malayan-tapir/WoBo40/hardware/wobo40/wobo40.kicad_sch

## KiCad design hardware/wobo40/wobo40.kicad_sch (2026-09-09)

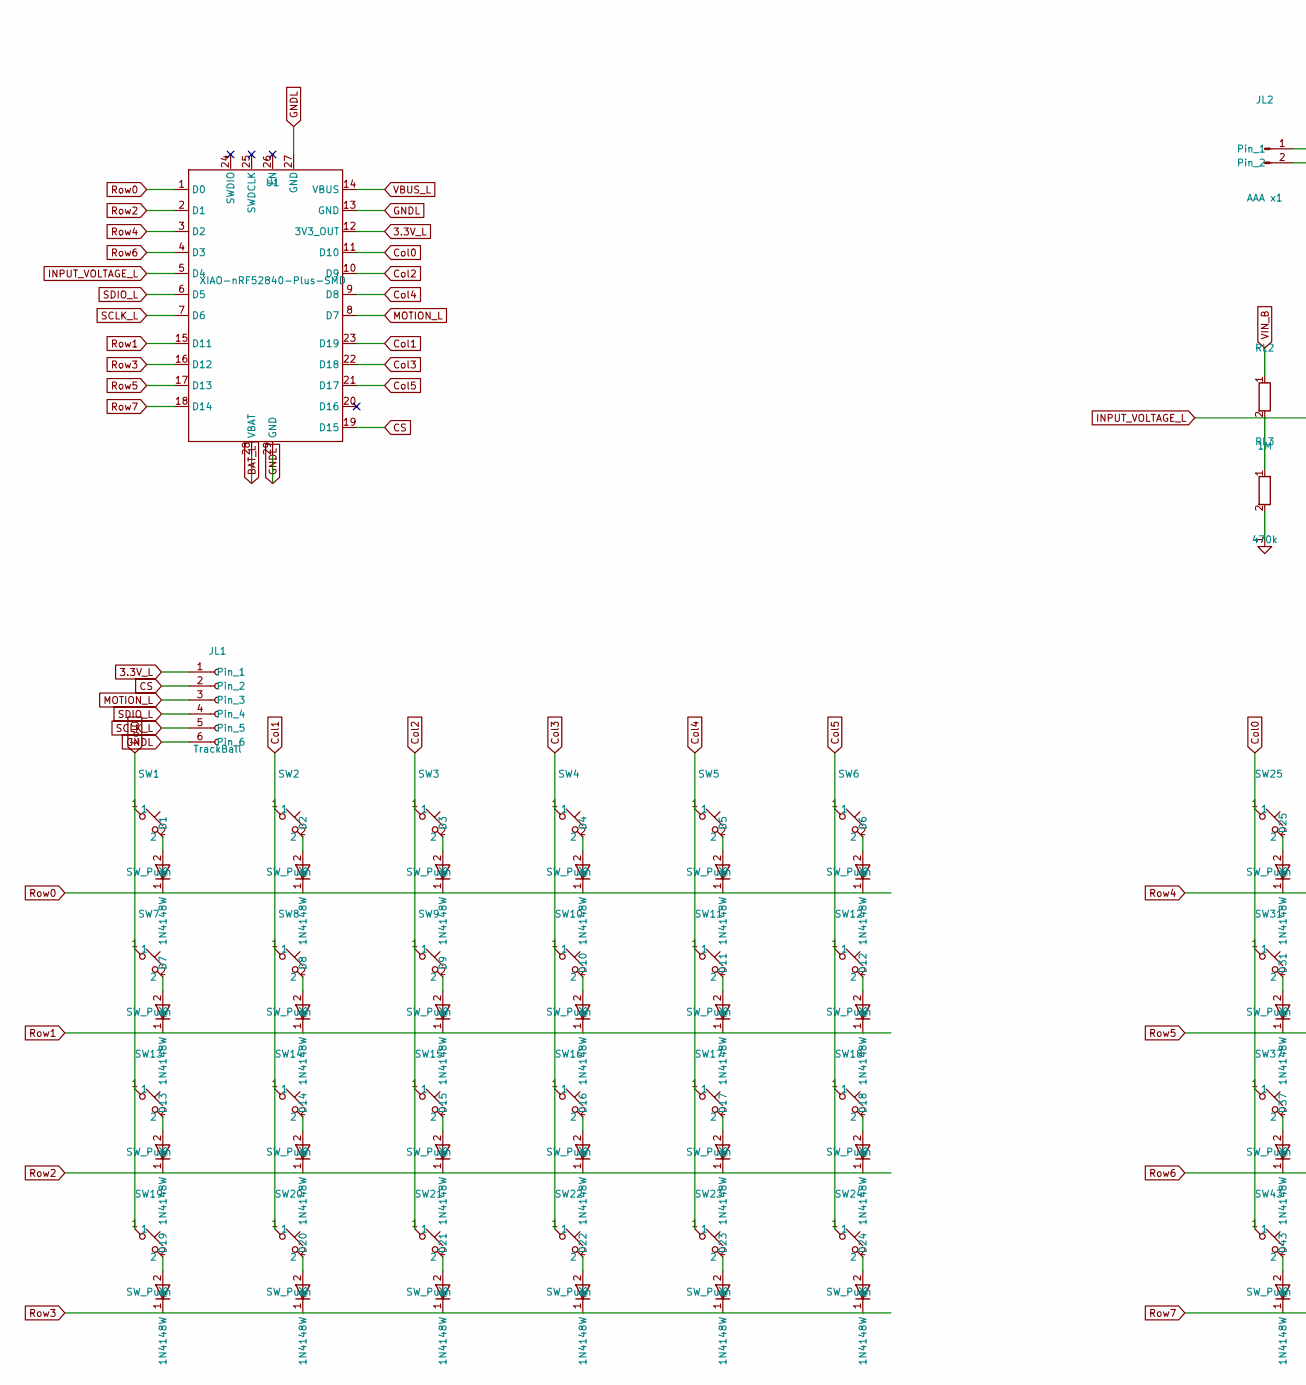
[picture p1: schematic wobo40.kicad_sch, part in row 1, column 1]

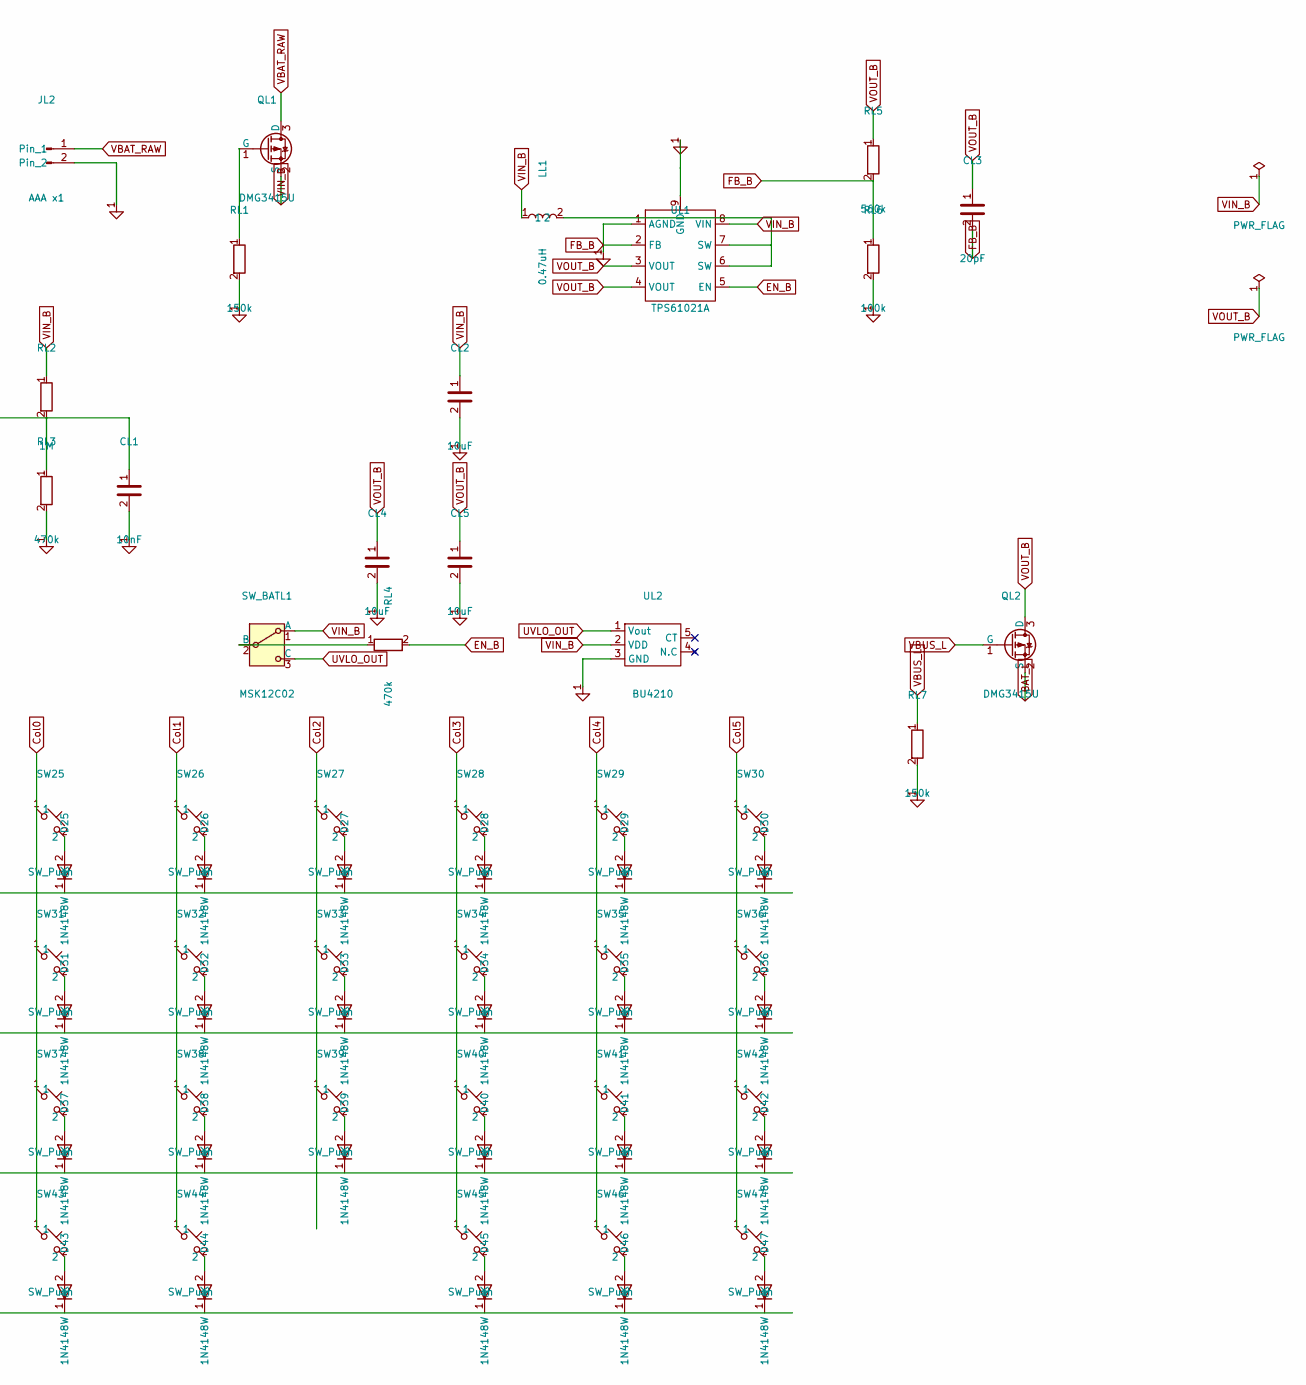
[picture p2: schematic wobo40.kicad_sch, part in row 1, column 2]

Parts:
CL1: 10nF; C_0603_1608Metric
CL2, CL4, CL5: 10uF; C_0603_1608Metric
CL3: 20pF; C_0603_1608Metric
D1, D2, D3, D4, D5, D6, D7, D8, D9, D10, D11, D12, D13, D14, D15, D16, D17, D18, D19, D20, D21, D22, D23, D24, D25, D26, D27, D28, D29, D30, D31, D32, D33, D34, D35, D36, D37, D38, D39, D40, D41, D42, D43, D44, D45, D46, D47: 1N4148W; D_SOD-123
JL1: TrackBall; JST_SH_SM06B-SRSS-TB_1x06-1MP_P1.00mm_Horizontal
JL2: AAA x1
LL1: 0.47uH; L_1008_2520Metric
QL1, QL2: DMG3415U; SOT-23
RL1, RL7: 150k; R_0603_1608Metric
RL2: 1M; R_0603_1608Metric
RL3, RL4: 470k; R_0603_1608Metric
RL5: 560k; R_0603_1608Metric
RL6: 100k; R_0603_1608Metric
SW1, SW2, SW3, SW4, SW5, SW6, SW7, SW8, SW9, SW10, SW11, SW12, SW13, SW14, SW15, SW16, SW17, SW18, SW19, SW20, SW21, SW22, SW23, SW24, SW25, SW26, SW27, SW28, SW29, SW30, SW31, SW32, SW33, SW34, SW35, SW36, SW37, SW38, SW39, SW40, SW41, SW42, SW43, SW44, SW45, SW46, SW47: SW_Push
SW_BATL1: MSK12C02
U1: XIAO-nRF52840-Plus-SMD
UL1: TPS61021A; WSON-8-1EP_2x2mm_P0.5mm_EP0.9x1.6mm
UL2: BU4210; SSOP-5_1.6x1.6mm_P0.5mm

Connections:
3.3V_L: JL1.1, U1.12 (3V3_OUT)
BAT_L: QL2.2 (S), U1.28 (VBAT)
CS: JL1.2, U1.19 (D15)
Col0: SW19.1, SW43.1, U1.11 (D10)
Col1: SW20.1, SW44.1, U1.23 (D19)
Col2: SW21.1, U1.10 (D9)
Col3: SW22.1, SW45.1, U1.22 (D18)
Col4: SW23.1, SW46.1, U1.9 (D8)
Col5: SW24.1, SW47.1, U1.21 (D17)
EN_B: RL4.2, UL1.5 (EN)
FB_B: CL1.2, CL2.2, CL3.2, CL4.2, CL5.2, JL2.2, RL1.2, RL3.2, RL5.2, RL6.1, RL6.2, RL7.2, UL1.1 (AGND), UL1.2 (FB), UL1.9 (GND), UL2.3 (GND)
GNDL: JL1.6, U1.13 (GND), U1.27 (GND), U1.29 (GND)
INPUT_VOLTAGE_L: CL1.1, RL2.2, RL3.1, U1.5 (D4)
MOTION_L: JL1.3, U1.8 (D7)
unnamed: D1.2 (A), SW1.2
unnamed: D2.2 (A), SW2.2
unnamed: D3.2 (A), SW3.2
unnamed: D4.2 (A), SW4.2
unnamed: D5.2 (A), SW5.2
unnamed: D6.2 (A), SW6.2
unnamed: D7.2 (A), SW7.2
unnamed: D8.2 (A), SW8.2
unnamed: D9.2 (A), SW9.2
unnamed: D10.2 (A), SW10.2
unnamed: D11.2 (A), SW11.2
unnamed: D12.2 (A), SW12.2
unnamed: D13.2 (A), SW13.2
unnamed: D14.2 (A), SW14.2
unnamed: D15.2 (A), SW15.2
unnamed: D16.2 (A), SW16.2
unnamed: D17.2 (A), SW17.2
unnamed: D18.2 (A), SW18.2
unnamed: D19.2 (A), SW19.2
unnamed: D20.2 (A), SW20.2
unnamed: D21.2 (A), SW21.2
unnamed: D22.2 (A), SW22.2
unnamed: D23.2 (A), SW23.2
unnamed: D24.2 (A), SW24.2
unnamed: D25.2 (A), SW25.2
unnamed: D26.2 (A), SW26.2
unnamed: D27.2 (A), SW27.2
unnamed: D28.2 (A), SW28.2
unnamed: D29.2 (A), SW29.2
unnamed: D30.2 (A), SW30.2
unnamed: D31.2 (A), SW31.2
unnamed: D32.2 (A), SW32.2
unnamed: D33.2 (A), SW33.2
unnamed: D34.2 (A), SW34.2
unnamed: D35.2 (A), SW35.2
unnamed: D36.2 (A), SW36.2
unnamed: D37.2 (A), SW37.2
unnamed: D38.2 (A), SW38.2
unnamed: D39.2 (A), SW39.2
unnamed: D40.2 (A), SW40.2
unnamed: D41.2 (A), SW41.2
unnamed: D42.2 (A), SW42.2
unnamed: D43.2 (A), SW43.2
unnamed: D44.2 (A), SW44.2
unnamed: D45.2 (A), SW45.2
unnamed: D46.2 (A), SW46.2
unnamed: D47.2 (A), SW47.2
unnamed: LL1.2, UL1.6 (SW), UL1.7 (SW)
unnamed: QL1.1 (G), RL1.1
unnamed: RL4.1, SW_BATL1.2 (B)
Row0: U1.1 (D0)
Row1: U1.15 (D11)
Row2: U1.2 (D1)
Row3: U1.16 (D12)
Row4: U1.3 (D2)
Row5: U1.17 (D13)
Row6: U1.4 (D3)
Row7: U1.18 (D14)
SCLK_L: JL1.5, U1.7 (D6)
SDIO_L: JL1.4, U1.6 (D5)
UVLO_OUT: SW_BATL1.3 (C), UL2.1 (Vout)
VBAT_RAW: JL2.1, QL1.3 (D)
VBUS_L: QL2.1 (G), RL7.1, U1.14 (VBUS)
VIN_B: CL2.1, LL1.1, QL1.2 (S), RL2.1, SW_BATL1.1 (A), UL1.8 (VIN), UL2.2 (VDD)
VOUT_B: CL3.1, CL4.1, CL5.1, QL2.3 (D), RL5.1, UL1.3 (VOUT), UL1.4 (VOUT)
