malayan-tapir/WoBo40/(commit log)

2026-07-12 WoBo40: XIAO BLE + ZMK + 1Uトラックボール構成一式を追加
    - 4行x13列 (51キー) オーソリニア、トラックボール位置(Row3/C8)は除外
    - 列駆動: 74HC595 x2 をSPI1で駆動 (ZMK標準 zmk,gpio-595, ngpios=16)
    - トラックボール: PMW3610 (inorichi/zmk-pmw3610-driver, SPI0 3線接続)
    - ボール移動でMouseレイヤー自動有効化、fn押下中はスクロール
    - キーマップ: Base / Mouse / Fn / Sys の4レイヤー (Mac/JIS想定, 英数/かな対応)
    - ZMK Studio対応 (physical layout定義 + studioビルド)
    - GitHub Actionsビルドマトリクス: studio版 / 通常版 / settings_reset
    - 配線・ピンアサイン・使い方をREADMEに記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
2026-07-13 キースキャンをCharlieplex方式に変更 (74HC595を廃止)
    - スキャン8ピン (D0-D3, D8-D10, NFC1/P0.09) + 割り込み1ピン (NFC2/P0.10)
    の zmk,kscan-gpio-charlieplex 構成に変更 (8x7=56ポジション中51使用)
    - NFCピンGPIO化のため CONFIG_NFCT_PINS_AS_GPIOS=y を追加
    - transform を駆動ピン→受信ピンのペア割当に書き換え (キーマップは不変)
    - README: 部品表 (ダイオード102本)、結線ルール図、キーごとの
    ピンペア結線表 (transformと1対1対応、スクリプト生成) に更新
    - トラックボール (PMW3610, D4-D7) は変更なし
    ローカルでseeeduino_xiao_ble向けビルド検証済み (zmk.uf2生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
2026-07-13 XIAO nRF52840 Plus対応: 8行x7列マトリクス(行2段重ね)に変更
    - 対象マイコンをXIAO nRF52840 Plusに変更 (裏面パッドD11-D19を使用)
    - Charlieplexを廃止し、通常のCOL2ROWマトリクスに戻す
    (ダイオードはキーあたり1本の計51本に削減、配線も一般的な方式に)
    - 物理4行x13列を左右ブロックに分割し、右ブロック(C8-C13)は
    行線D11-D14、列線は左ブロックと共用する8x7構成 (15ピン)
    - D14/D15(NFCピン)は引き続きGPIO化 (CONFIG_NFCT_PINS_AS_GPIOS=y)
    - D16(P0.31)は電池電圧測定用のため使用しないことを明記
    - README: Plus用の配線表(行線/列線)・ピンアサイン・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
2026-07-14 47キー(8x6)構成に変更: 回路図の新ピン配置に合わせて全面更新
    - 物理レイアウトを4x12(47キー)に変更 (左端の独立列C1-C4を廃止)
    - 電気マトリクスを8x6の行2段重ねに変更、ピン配置を回路図と一致させる
    行: D1,D2,D3,D11(左) / D12,D13,D14,D8(右)
    列: D9,D10,D17,D15,D18,D19 (左右共用)
    トラックボール(PMW3610): D4,D5,D6,D7 (変更なし)
    - キーマップを47キー4レイヤーに再構成
    (Sysレイヤーへの入口を廃止したC1列から左スペース隣のSYSキーへ移設)
    - D0(AIN0)は電池電圧監視用に確保(ファーム未使用)
    - README: 配線表(行線/列線)・ピンアサイン・J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
2026-07-14 トラックボールをPAW3222に変更
    - ドライバを inorichi/zmk-pmw3610-driver から
    sekigon-gonnoc/zmk-driver-paw3222 へ差し替え (west.yml)
    - overlay: trackballノードを pixart,paw3222 に変更、res-cpi=800
    MOTIONピンは GPIO_ACTIVE_LOW
    - PAW3222ドライバにはscroll/automouse機能が無いため、ZMK標準の
    input processorで再実装:
    input-processors = <&zip_temp_layer 1 400> (ボール移動でMouse自動有効)
    scroller { layers=<2>; zip_xy_to_scroll_mapper } (Fn中スクロール)
    #include <input/processors.dtsi> を追加
    - conf: CONFIG_PMW3610* を削除、CONFIG_PAW3222=y に
    - README/overlayコメントをPAW3222向けに更新
    ロー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
2026-08-02 新レイアウトに更新: トラックボールを4行目9列目へ
    - 物理配列を変更 (アルファベットを左右5列ずつに寄せ、中央2列を新設)
    Q W E R T | Esc BSpc | Y U I O P
    A S D F G | Tab Ent | H J K L -
    Z X C V B | Sft Sft | N M , . /
    Ctl Opt Cmd SYS 英数 | Spc Spc | かな [TB] fn LClk RClk
    - トラックボール位置を RC(7,2) に変更 (回路図のRow7欠番=Col2と一致)
    - transform と physical-layout の欠番位置を更新
    - キーマップを新配列に合わせて4レイヤーとも再構成
    - トラボ右隣に fn を配置 (押下中スクロール)
    - 最下段右2キーを左右クリックに割当
    - Fnレイヤー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
2026-08-02 PCB配線最適化: ピン配置を機能別・連番に再割当
    現状の配置ではRow7だけが下辺、Col3だけが上辺に分断され、
    さらに行の並び順がバラバラで配線が交差していたため整理した。
    - 行8本を上辺の左端に Row0〜Row7 の連番で配置
    D0, D11, D1, D12, D2, D13, D3, D14
    - 列6本を下辺の左端に Col0〜Col5 の連番で配置
    D10, D19, D9, D18, D8, D17
    (基板の左→右の列順とパッドの並びが一致し、扇状に展開できる)
    - トラックボール4本をXIAOの右端に集約
    nCS=D15, SDIO=D5, SCLK=D6 (上辺右端) / MOTION=D7 (下辺右端)
    - NFCピン(D14/D15)は低速信号(行スキャ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
2026-09-09 単4電池1本で動作するKiCadプロジェクトを新規作成
    回路図をスクリプトから生成し、KiCadを起動せずにネット検証まで行う構成にした。
    hardware/wobo40/ : KiCadプロジェクト
    - 47キー + 1Uトラックボール、電気8行x6列(行2段重ね)
    - XIAO nRF52840 Plus、ピン割当はファーム(wobo40.overlay)と1対1一致
    - 電源: 単4x1 → TPS61021A で3.3V昇圧 → XIAO VBAT
    逆接保護(QL1) / USB逆流防止(QL2) / 1.0Vカットオフ(BU4210)
    電池電圧モニタ(D4/AIN2)
    - FB分圧は 560k/100k = 3.3V (VFB 0.5V から算出)
    - 意図的な未接続ピン(D16/SWD/EN/BU42のCT,N.C)に未接続フラグ
    - ERC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
    [wobo40.kicad_sch]
